PauvreChevalierDuChrist/VeloArduino/Rapports/RapportDu06-02-2019.md

# Rapport du 6 février 2019 : Sacha PSALMON

Aujourd'hui fut une journée placée sous le signe du soulagement. Si j'avais terminé la dernière séance avec des moteurs qui ne marchaient plus, un gyroscope qui ne répondait plus comme il fallait, tout s'est arrangé. Je ne sais pas d'où provenait la "panne" des moteurs, probablement des piles ou du support à piles (que j'ai dû changé car il court circuit c'était produit pendant le stockage et l'avait en partie fait fondre. Quand vous transportez un objet de ce type, retirez toujours une des piles !). Pour ce qui est du gyroscope, j'ai tout bien rebranché et j'ai refais une calibration. Après ça tout s'est arrangé. Il se trouve que le petit moteur que nous avions a en fait bien assez de couple pour faire tourner le volant d'inertie. Cependant, l'ensemble "tremble" beaucoup lorsque la roue tourne rapidement. En effet, étant donné qu'il y a plus de poids d'un côté de la roue (celle ci n'étant pas symétrique) et que le moteur n'est pas exactement au centre, quelques problèmes apparaissent. Nous avons donc décidé avec Enzo de refaire une autre roue, cette fois en la fabriquant au Fab Lab via découpe laser. Nous aurons ainsi un résultat beaucoup plus précis et fiable. 

La structure du vélo semble être presque terminée. Tout tient en place, les roues tournent bien. Il va maintenant nous falloir fabriquer (au fab lab encore une fois) des pièces de bois qui serviront de support pour la carte arduino et l'ensemble volant-moteur. Nous allons très probablement visser la carte arduino au bas du vélo et fabriquer un "panneau" vertical avec un trou dans lequel nous colleront le volant d'inertie.

J'ai donc passé une partie de ma séance à aider Enzo à modéliser tout ça sur le logiciel Fusion 360 (car sans une structure acceptable je ne peux pas travailler sur le PID car sa configuration nécessite de beaucoup expérimenter). Etant donné que je ne le connaissait pas j'ai eu un peu de mal à faire ce que je voulais mais voilà à peu près ce à quoi la roue d'inertie devrait ressembler (soyez indulgents, j'ai mis au moins 30 minutes à faire ça ...): 

C'est beau.

Les trous sur les côtés sont là pour fixer une plaque en métal rectangulaire qui servira à "fixer" le moteur (on la troue, on fait passer le rotor du moteur à l'intérieur et on bourine dessus pour que le rotor soit bien coincé). Ou alors on collera le rotor dans le trou central, on ne sait pas encore.

Merci de m'avoir lu.

Bonne journée.
