PauvreChevalierDuChrist/VeloArduino/Rapports/RapportDu13-02-2019.md

# Rapport du 13 février 2019 : Sacha PSALMON

Cette scéance fut relativement peu productive. Pour continuer notre projet nous devions aller au fablab, pour finaliser le vélo afin de pouvoir attaquer le PID, mais celui ci était fermé. J'ai donc passé la séance à modéliser - avec le logiciel Fusion 360 - les pièces de bois qui permettront de fixer la roue d'inertie au vélo. Nous aurions pu les découper à la main mais nous avons préféré le faire grâce à la découpe laser du fablab. En effet, nos pièces sont assez petites (quelque centimètres) et demandent une grande précision au niveau de l'équilibrage du poids (pour éviter les problèmes comme la roue qui tremblait énormément). Enzo de son côté a travaillé sur le vélo pour trouver une solution pour fixer la carte arduino au vélo. Après moult essais et echecs il s'est rabattu sur les classiques colliers de serras qui nous sauvent encore une fois la vie :

C'est beau.

Le lendemain nous nous sommes rendus au fablab et après une petite erreur (voir les pièces en version miniature au fond la photo) due au fait que les mesures sur inkscape étaient en pixels et non en mm, nous avons finalement nos pièces de bois : 

C'est beau.

La séance prochaine nous assemblerons donc tout ça et nous pourrons continuer serainement.

Merci de m'avoir lu, bonne journée.
