PauvreChevalierDuChrist/VeloArduino/Rapports/RapportDu27-02-2019.md

# Rapport du 27 février 2019 : Sacha PSALMON

Cette séance fut placée sous le signe de la déception. Nous avons avec Enzo assemblé toutes les pièces que nous avions fabriqué au fablab la semaine dernière. De ce côté là, tout s'est bien passé. Voilà une photo du vélo "finalisé" : 

C'est beau.

Nous ne pouvions pas tester le projet avant aujourd'hui et le test fut loin d'être concluant. Ce n'est pas un problème de programmation, en effet, le programme répond bien, il faudrait juste régler le PID (ce qui se fait de manière totalement empirique). Cependant, nous avons sous estimé la création d'inertie nécessaire à l'équilibrage du vélo. Notre roue d'inertie n'est pas du tout assez massive et nous ne pouvons pas énormément l'alourdir car notre moteur n'a pas un grand couple. De plus nous n'avons pas le temps de commander un moteur plus puissant, de refaire une roue d'inertie cette fois bien massive et de refaire toute la structure pour soutenir le moteur (étant donné que son diamètre ne sera sûrement pas le même que celui que nous avons actuellement). Dans le doute, nous allons retourner au fablab pour découper des "roues" supplémentaires que nous collerons sur celle déja en place en espérant que ça l'alourdisse assez. Il est cependant fort probable que le projet n'aboutisse pas (et c'est bien dommage). Si c'est le cas, au moins les erreurs seront comprises et nous serons à même de les expliquer lors de l'oral. Les pièces fabriquées et l'assemblage sont en tout cas d'une grande qualité (à mon humble avis).

Ce projet nous aura en tout cas permis de nous intéresser à beaucoup de chose et d'aborder un sujet complexe à savoir le PID, nous ne perdons pas espoir.
