PauvreChevalierDuChrist/VeloArduino/Rapports/RapportDu07-03-2019.md

# Rapport du 7 mars 2019 : Sacha PSALMON

Aujourd'hui était techniquement notre dernière scéance d'Arduino consacrée aux projets. Autant dire que le notre est loin d'être terminé. Nous sommes bien allés au fablab pour découper des roues plus lourdes (que vous pourrez voir en photo un peu plus bas) mais ça ne suffit pas. Nous en avons trois au total mais notre petit moteur peine déjà à en faire tourner deux sans qu'un effet probant soit observable. Nous avons essayé de bidouiller les paramètres du PID mais rien n'y fait. Si je devais me donner un conseil à mon moi du passé, ce serait de faire une structure ayant un centre de masse beaucoup plus bas et de préparer un volant d'inertie au moins aussi lourd que le reste de la structure. La masse de ce dernier est en fait TRES importante et c'est quelque chose que nous ignorions, tant pis. Après de nombreux essais infructueux je me suis donc lancé dans la programmation du module bluetooth pour qu'au moins la vitesse de notre roue arrière soit controlable via un téléphone (c'est un minimum). J'ai réussi à configurer le module (ce n'était pas très dur, nous l'avions déjà étudié en classe), mais la roue ne semble pas encore réagir aux ordres donnés par le smartphone. Je veillerais à résoudre ces problèmes demain. 

Voilà les roues que nous avons imprimé au fablab, deux d'entre elles sont collées, chaque roue est à peu près deux fois plus épaisse que l'ancienne roue que nous avions et le bois est beaucoup plus lourd.

C'est beau.

Je termine donc mon dernier rapport, un peu déçu, je l'avoue, de rendre un vélo qui roule mais qui tombe.

Merci de m'avoir lu.

C'est beau.
