PauvreChevalierDuChrist/VeloArduino/Rapports/RapportDu18-01-2019.md

# Rapport du 18 janvier 2019 : Sacha PSALMON

J'ai consacré ma séance d'aujourd'hui à l'élaboration de la roue d'inertie. Nous avons décidé de la faire à partir de bois car c'était selon nous la meilleure matière en terme de rapport solidité-légèretée-facilitée à la travailler. Par chance, notre professeur possédait déjà un cercle de bois de la bonne taille (d'après nous). Etant donné que la pièce était déjà trouée au centre, il nous fallait trouver un autre moyen pour fixer notre moteur à la roue. Au final, nous avons pris un morceau de métal (que je suppose être de l'alluminium) que nous avons percé. Nous avons d'ailleurs percé le morceau qui devait être le morceau final complètement de travers, donc nous utiliserons un morceau "test" bien plus réussi à ce niveau là. Le métal est ensuite vixé à la roue en bois à l'aide de vis on ne peut plus classiques. 

Voilà donc à quoi ressemble l'ensemble moteur-roue pour le moment : 

C'est beau.

Cependant, à partir de ce moment là, tout s'est mal déroulé. Nos inquiétudes primaires face au manque de couple du moteur étaient justifiées, le volant d'inertie ne peut pas tourner. Il nous faudra donc trouver un moteur plus puissant à ce niveau là (un moteur avec un couple correct et une grande vitesse de rotation donc). De plus, par je ne sais quel malheur, les moteurs ont cessé de fonctionner. La source du problème n'a pour le moment pas encore été identifiée. Ce n'est pas un problème de piles (je les ai changé et j'ai checké le voltage, tout est bon). Etant donné que j'ai testé avec deux moteurs du même modèle, je doute que ce soit un problème de moteur. 

Je vais en attendant la prochaine scéance refaire tout les cablages afin de faire tout remarcher. Dans tout les cas, le gyroscope fonctionne. 

De son côté, Enzo a avancé sur la structure du vélo, voilà ce que ça donne pour l'instant : 

C'est beau.
