PauvreChevalierDuChrist/VeloArduino/Rapports/RapportDu14-12-2018.md

# Rapport du 14 décembre 2018 : Sacha PSALMON

La scéance dernière nous avons réalisé quelques calculs et résolu un bon nombre de problèmes relevant de la mécanique. Le but était de comprendre pourquoi est ce que faire tourner une roue accrochée à un vélo (verticalement) permettait de l'équilibrer. C'est au final dû à la force dirrectement induite par le moment de rotation de la roue, nous détaillerons cela dans des schémas ultérieurs. 

Aujourd'hui nous nous sommes aussi concentrés sur la mise en place d'un GitHub pour réunir notre travail et sur la rédaction d'un cahier des charges.

Nous avons aussi fait des recherches quant au matériel à utiliser pour notre projet et nous nous sommes arrêtés sur : 

-les Roues GMPW bleus pour moteurs série GM.
-Un moteur probablement de la gamme addaptée aux roues.

Nous avons aussi envisagé la possibilité d'utiliser des roues imprimées en 3D, mais le résultat aurait été bien moins bon que des roues industrielles.

Nous avons déjà pensé à un partage des taches du projet, à savoir : 

-Moi, Sacha PSALMON, m'occuperait du PID et de l'asservissement de la roue d'intertie.
-Enzo ISNARD s'occupera de la création du vélo (physiquement, afin qu'il soit matériellement existant), ainsi que de la partie communication et déplacements. 

Le partage du travail n'est probablement pas définitif. 

Merci de m'avoir lu. 

Bonne journée.
