PauvreChevalierDuChrist/VeloArduino/Rapports/RapportDu18-12-2018.md

# Rapport du 18 décembre 2018 : Sacha PSALMON

Aujourd'hui nous avons fini de trouver le matériel à commander. Nous sommes normalement au point à ce niveau là. Enzo a proposé l'idée d'utiliser des briques LEGO pour faire la structure du vélo, ça serait plus simple et plus léger en effet que de la faire en bois et bien moins chronophage que de l'imprimer en 3D.

Nous avons fait nos premiers tests avec des moteurs en utilisant le Motor Driver. Tout s'est passé sans réels accrocs, les schémas du cours étaient très clairs, tout marchait bien à la fin de la séance.

Nous nous sommes ensuite attaqués à l'accéléromètre (nous utiliserons un MPU 6050 qui combine un accéléromètre et un gyroscope, car c'est bien plus précis). Malgré un suivi minutieux des instructions données dans le cours sur le sujet, nous ne sommes pas parvenus à un résultat satisfaisant. Nous n'arrivons pour l'instant pas à afficher les valeurs d'angle (on n'obtient que des caractères spéciaux incompréhensibles) malgré l'utilisation d'un code spécifique à ce modèle trouvé sur Internet (dédicace à Luis Rodenas), je chercherais à résoudre ça pendant les vacances. Il faudrait aussi souder proproment l'accéléromètre, c'est peut être de là que vient le problème. 

Le projet avance pour l'instant à une vitesse convenable, nous devrons peut être changer le moteur donné par notre professeur (qui était prédestiné à servir pour faire tourner le volant d'inertie) car son couple semble vraiment faible. J'essaierais pendant les vacances de trouver un vieux disque dur inutilisé pour récupérer son moteur. 

Merci de m'avoir lu.

Bonne journée.
