PauvreChevalierDuChrist/VeloArduino/Rapports/planning.ods

 | Semaine 1 | Semaine 2 | Semaine 3 | Semaine 4 | Semaine 5 | Semaine 6 | Semaine 7 | Semaine 8 | Semaine 9
Définition | Nous deux
Achats | Nous deux
Gyroscope |  | Sacha
Roues |  | Enzo | Enzo | Enzo
Volant inertie |  |  |  | Sacha | Sacha | Sacha | Sacha | Sacha
Déplacement |  |  | Enzo | Enzo | Enzo | Enzo
Programmation du volant |  |  | Sacha | Sacha | Sacha | Sacha | Sacha | Sacha
Tourner
Bluetooth |  |  |  |  |  |  |  | Sacha | Sacha
Structure |  | Enzo | Enzo | Enzo | Enzo | Nous deux | Nous deux | Enzo
Correction des bugs du 1er semestre
Tests, corrections et optimisation
Finalisation et dernières vérifications |  |  |  |  |  |  |  | Nous deux | Nous deux
 | Semaine 1 | Semaine 2 | Semaine 3 | Semaine 4 | Semaine 1 | Semaine 2 | Semaine 3 | Semaine 4 | Semaine 5
Définition | Nous deux
Achats | Nous deux
Gyroscope |  |  |  | Sacha
Volant inertie |  |  | Sacha | Sacha | Sacha
Déplacement |  |  |  | Enzo | Enzo | Enzo
Programmation du volant |  |  |  |  | Sacha | Sacha | Sacha | Sacha
Tourner |  |  |  |  |  | Enzo | Enzo | Enzo
Bluetooth |  |  |  |  | Sacha | Sacha
Dessin des plans |  | Nous deux | Nous deux
Réalisation de la structure |  |  |  | Sacha
Finalisation et dernières vérifications |  |  |  |  |  |  |  |  | Nous deux
